dl3yc/SSTV-RX/README.md

SSTV-RX
=======

a reciever for SSTV on 2m ham radio band as software defined radio
