dl3yc/SSTV-RX/hw/images/adf4360_full.jpg

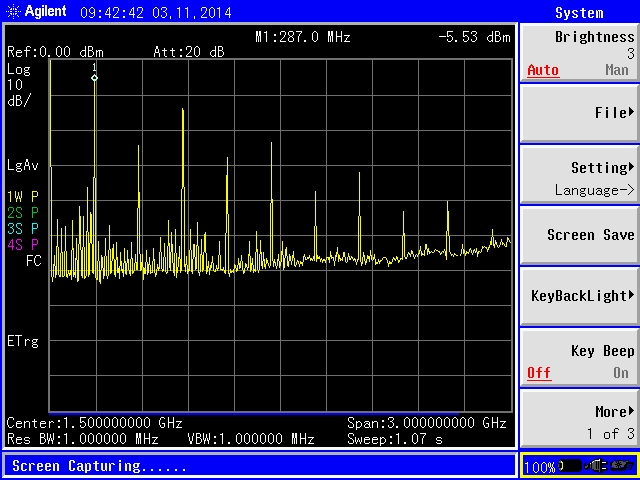
hw/images/adf4360_full.jpg
