dl3yc/SSTV-RX/hw/images/adf4360_narrow.jpg

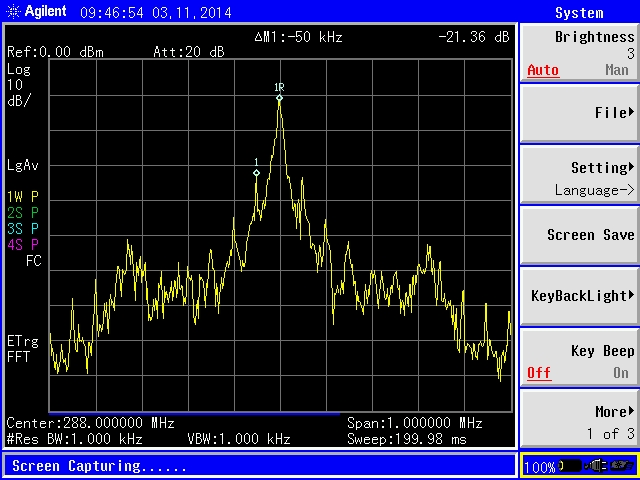
hw/images/adf4360_narrow.jpg
