dl3yc/SSTV-RX/hw/images/adf4360_spurs.jpg

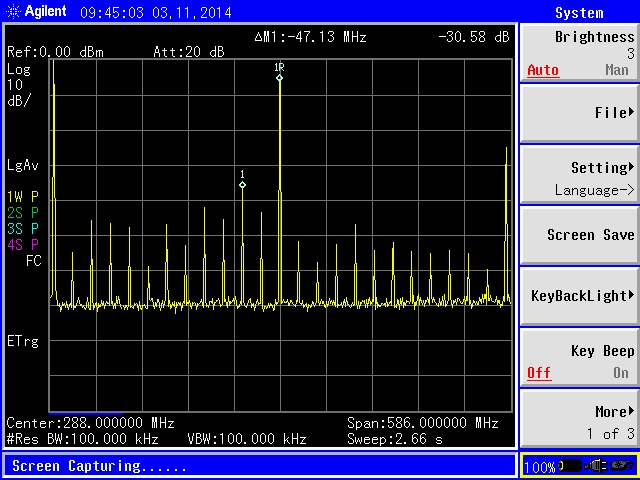
hw/images/adf4360_spurs.jpg
