dl3yc/SSTV-RX/hw/sim/pllsim.png

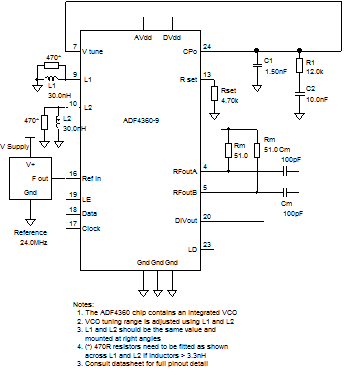
hw/sim/pllsim.png
