dl3yc/SSTV-RX/hw/sim/signal_chain.png

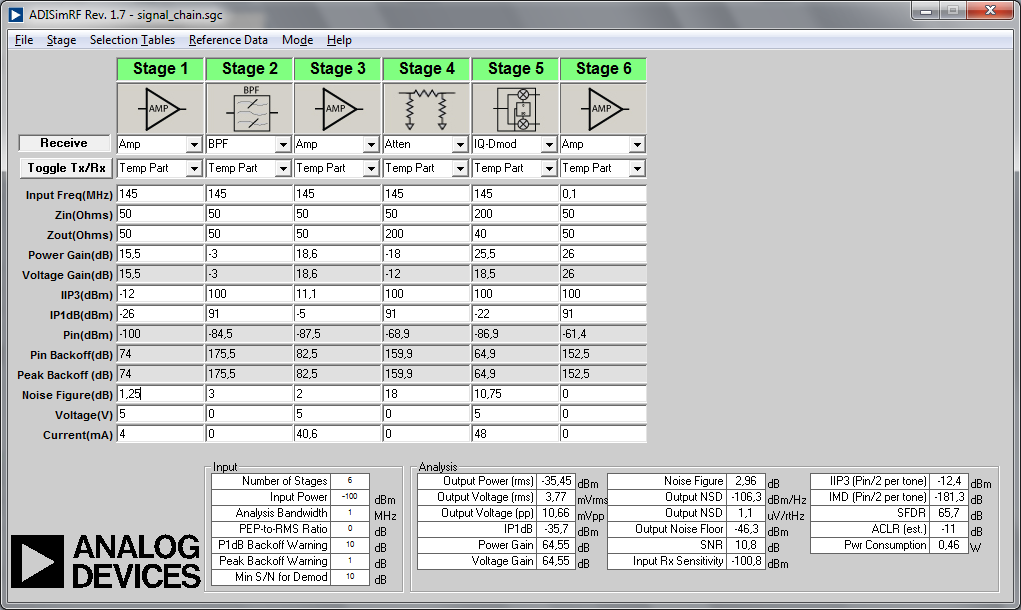
hw/sim/signal_chain.png
