dl3yc/SSTV-RX/hw/sim/BB-Filter.asc

C1: cap; 1n
C2: cap; 220p
L1: ind; 10µ
L2: ind; 4µ7
R1: res; 60
R2: res; 100
R3: res; 50k
V1: voltage; ""; AC 1; Rser=40
Named nets: 0, OUT, IN
.ac oct 100 10k 100Meg
