dl3yc/SSTV-RX/hw/lo.brd

## EAGLE design hw/lo.brd (2014-03-10)

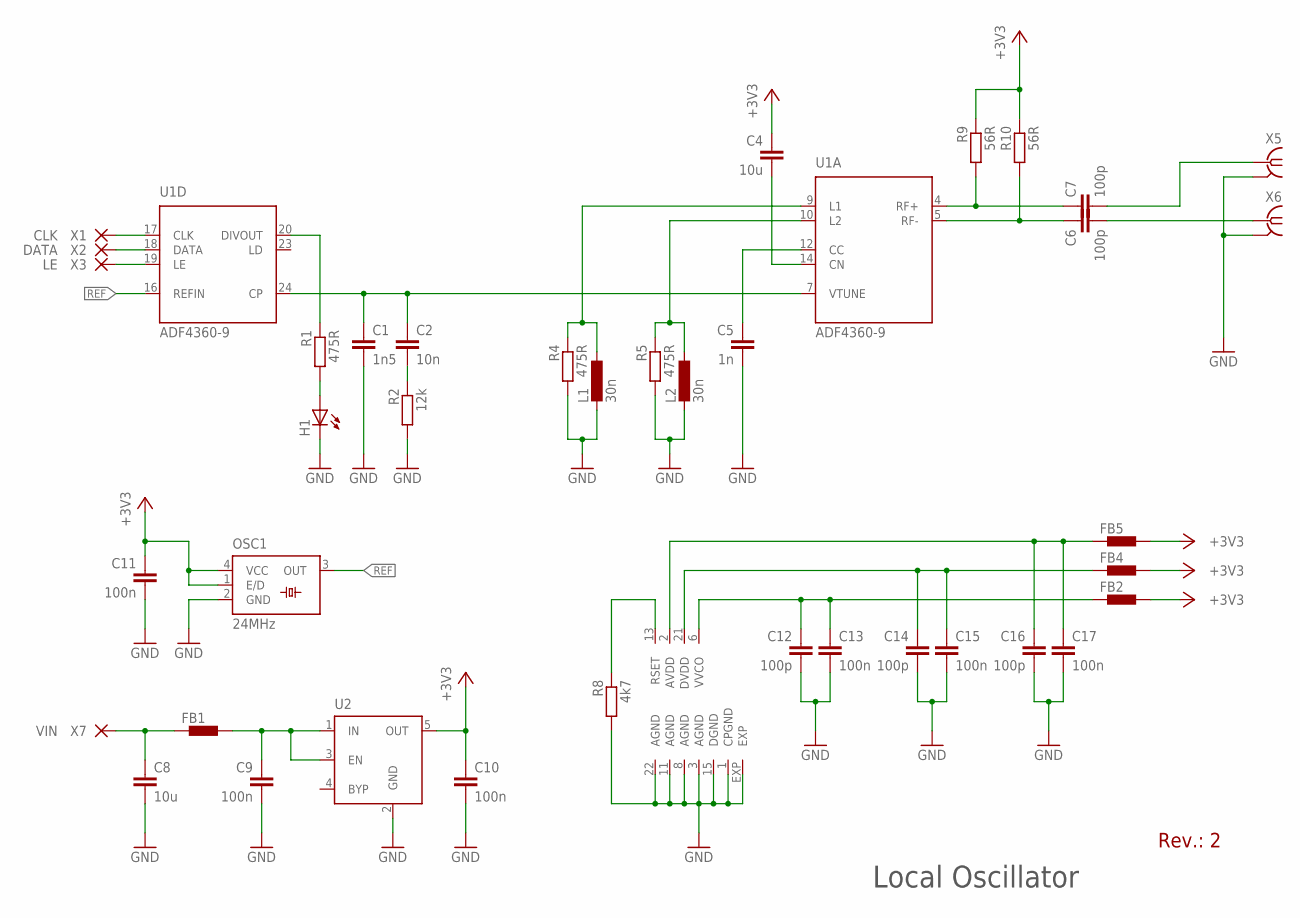
[picture p6: schematic lo.sch]

Parts:
C1: 1n5; C0402
C2: 10n; C0603
C4, C8: 10u; C0805
C5: 1n; C0603
C6, C7: 100p; C0402
C9, C10, C11, C13, C15, C17: 100n; C0603
C12, C14, C16: 100p; C0603
FB1, FB2, FB4, FB5: BML15H; R0603
H1: PL006-WCR13; SOT23
L1, L2: 30n; L2012C
OSC1: 24MHz; SM77H
R1: 475R; R1206
R2: 12k; R0603
R4, R5: 475R; R0603
R8: 4k7; R0603
R9, R10: 56R; R0603
U1: ADF4360-9; LFCSP24
U2: MIC5219XX; SOT23-5
X1: CLK; SMD1,27-2,54
X2: DATA; SMD1,27-2,54
X3: LE; SMD1,27-2,54
X5, X6: SMA-142-0701-881/886; J502-ND-142-0701-881/886
X7: VIN; SMD1,27-2,54

Connections:
+3V3: C4.1, C10.1, C11.1, FB2.2, FB4.2, FB5.2, OSC1.1 (E/D), OSC1.4 (VCC), R9.1, R10.1, U2.5 (OUT)
GND: C1.2, C5.2, C8.2, C9.2, C10.2, C11.2, C12.2, C13.2, C14.2, C15.2, C16.2, C17.2, H1.3 (C), L1.2, L2.2, OSC1.2 (GND), R2.2, R4.2, R5.2, R8.2, U1.1 (CPGND), U1.3 (AGND), U1.8 (AGND), U1.11 (AGND), U1.15 (DGND), U1.22 (AGND), U1.EXP, U2.2 (GND), X5.G@1 (GND), X5.G@2 (GND), X5.G@3 (GND), X5.G@4 (GND), X6.G@1 (GND), X6.G@2 (GND), X6.G@3 (GND), X6.G@4 (GND)
LD: C1.1, C2.1, U1.7 (VTUNE), U1.24 (CP)
unnamed: U1.17 (CLK), X1.1
unnamed: U1.18 (DATA), X2.1
unnamed: U1.19 (LE), X3.1
unnamed: C9.1, FB1.2, U2.1 (IN), U2.3 (EN)
unnamed: R1.1, U1.20 (DIVOUT)
unnamed: H1.1 (A), R1.2
unnamed: C2.2, R2.1
unnamed: C7.2, X5.1
unnamed: L2.1, R5.1, U1.10 (L2)
unnamed: C6.2, X6.1
unnamed: C5.1, U1.12 (CC)
unnamed: C8.1, FB1.1, X7.1
unnamed: C4.2, U1.14 (CN)
unnamed: C7.1, R9.2, U1.4 (RF+)
unnamed: C6.1, R10.2, U1.5 (RF-)
unnamed: R8.1, U1.13 (RSET)
unnamed: C12.1, C13.1, FB2.1, U1.6 (VVCO)
unnamed: C14.1, C15.1, FB4.1, U1.21 (DVDD)
unnamed: C16.1, C17.1, FB5.1, U1.2 (AVDD)
REF: OSC1.3 (OUT), U1.16 (REFIN)
RUT: L1.1, R4.1, U1.9 (L1)

Notes on the sheet:
Local Oscillator
Rev.: 2

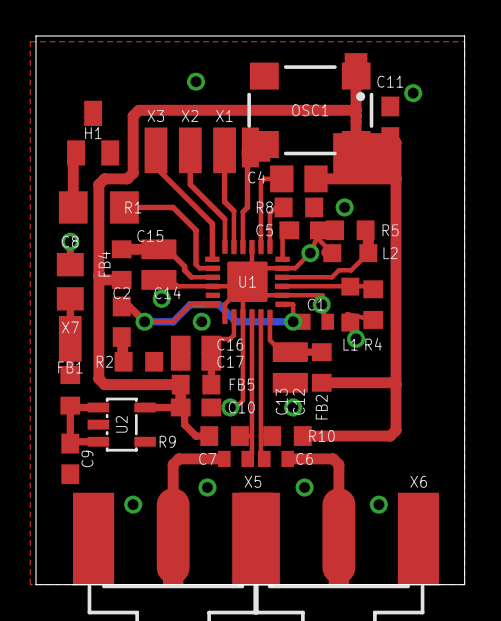
[picture p7: board lo.brd from above]

Board: 2 copper layers, 23.8 x 30.5 mm, 39 parts (0 on the bottom side), 24 nets.
