dl3yc/SSTV-RX/hw/diff2se.brd

## EAGLE design hw/diff2se.brd (2014-03-07)

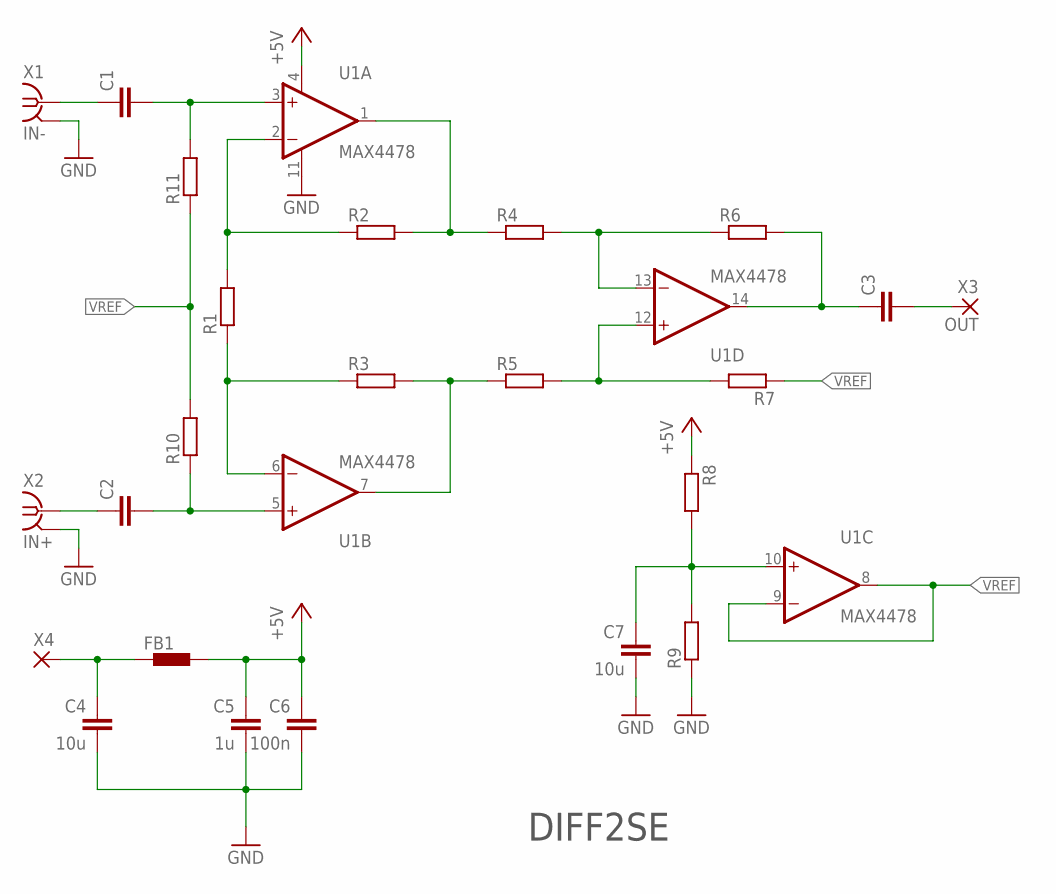
[picture p8: schematic diff2se.sch]

Parts:
C1, C2, C3: C-EUC0805K; C0805K
C4: 10u; C0805K
C5: 1u; C0805K
C6: 100n; C0805K
C7: 10u; C0402
FB1: BML15H; R0603
R1: R-EU_WSC01/2; WSC01/2
R2, R3, R4, R5, R6, R7: R-EU_R0805; R0805
R8, R9, R10, R11: R-EU_R0402; R0402
U1: MAX4478; SO14
X1: IN-; J502-ND-142-0701-881/886
X2: IN+; J502-ND-142-0701-881/886
X3: OUT; SMD1,27-2,54
X4: SMD2; SMD1,27-2,54

Connections:
+5V: C5.1, C6.1, FB1.2, R8.1, U1.4 (V+)
GND: C4.2, C5.2, C6.2, C7.2, R9.1, U1.11 (V-), X1.G@1 (GND), X1.G@2 (GND), X1.G@3 (GND), X1.G@4 (GND), X2.G@1 (GND), X2.G@2 (GND), X2.G@3 (GND), X2.G@4 (GND)
unnamed: R1.2, R2.1, U1.2 (-IN)
unnamed: R1.1, R3.1, U1.6 (-IN)
unnamed: R3.2, R5.1, U1.7 (OUT)
unnamed: R2.2, R4.1, U1.1 (OUT)
unnamed: C1.1, X1.1
unnamed: C1.2, R11.2, U1.3 (+IN)
unnamed: C2.1, X2.1
unnamed: C2.2, R10.1, U1.5 (+IN)
unnamed: R4.2, R6.1, U1.13 (-IN)
unnamed: R5.2, R7.2, U1.12 (+IN)
unnamed: C3.1, R6.2, U1.14 (OUT)
unnamed: C3.2, X3.1
unnamed: C4.1, FB1.1, X4.1
unnamed: C7.1, R8.2, R9.2, U1.10 (+IN)
VREF: R7.1, R10.2, R11.1, U1.8 (OUT), U1.9 (-IN)

Notes on the sheet:
DIFF2SE

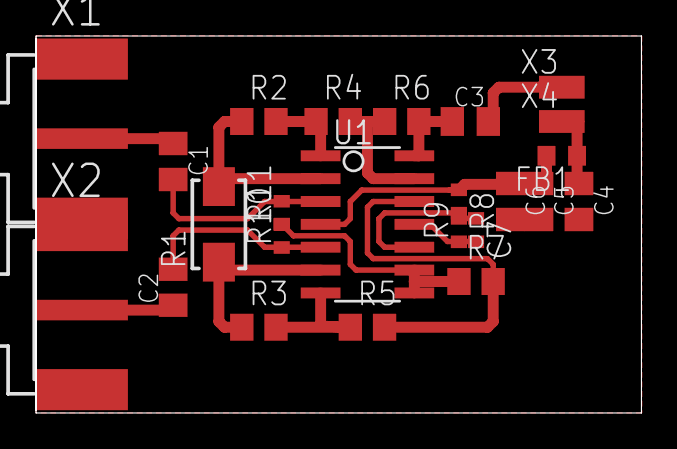
[picture p9: board diff2se.brd from above]

Board: 2 copper layers, 33.6 x 20.9 mm, 24 parts (0 on the bottom side), 17 nets.
