dl3yc/SSTV-RX/hw/iqdemod.brd

## EAGLE design hw/iqdemod.brd (2014-03-06)

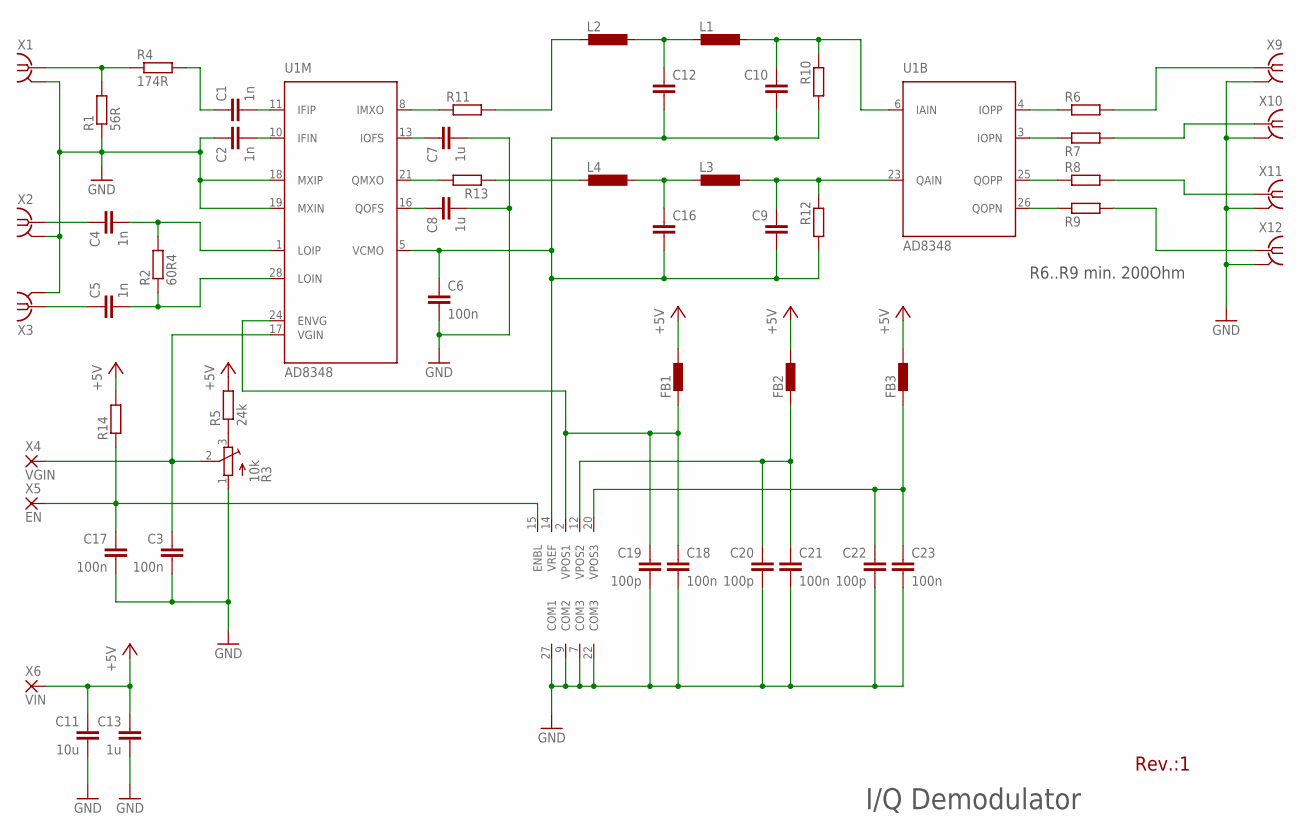
[picture p10: schematic iqdemod.sch]

Parts:
C1, C2, C4, C5: 1n; C0603
C3, C6, C17, C18, C21, C23: 100n; C0603
C7, C8, C13: 1u; C0603
C9, C10, C12, C16: C-EUC0603; C0603
C11: 10u; C0603
C19, C20, C22: 100p; C0603
FB1, FB2, FB3: BML15H; R0603
L1, L2, L3, L4: L-EUL2012C; L2012C
R1: 56R; R0603
R2: 60R4; R0603
R3: 10k; 3223J
R4: 174R; R0603
R5: 24k; R0603
R6, R7, R8, R9, R10, R11, R12, R13, R14: R-EU_R0603; R0603
U1: AD8348; TSSOP28
X1, X2, X3, X9, X10, X11, X12: SMA-142-0701-881/886; J502-ND-142-0701-881/886
X4: VGIN; SMD1,27-2,54
X5: EN; SMD1,27-2,54
X6: VIN; SMD1,27-2,54

Connections:
+5V: C11.1, C13.1, FB1.2, FB2.2, FB3.2, R5.2, R14.2, X6.1
GND: C2.1, C3.2, C6.2, C7.2, C8.2, C11.2, C13.2, C17.2, C18.2, C19.2, C20.2, C21.2, C22.2, C23.2, R1.1, R3.1 (A), U1.7 (COM3), U1.9 (COM2), U1.18 (MXIP), U1.19 (MXIN), U1.22 (COM3), U1.27 (COM1), X1.G@1 (2), X1.G@2 (2), X1.G@3 (2), X1.G@4 (2), X2.G@1 (2), X2.G@2 (2), X2.G@3 (2), X2.G@4 (2), X3.G@1 (2), X3.G@2 (2), X3.G@3 (2), X3.G@4 (2), X9.G@1 (2), X9.G@2 (2), X9.G@3 (2), X9.G@4 (2), X10.G@1 (2), X10.G@2 (2), X10.G@3 (2), X10.G@4 (2), X11.G@1 (2), X11.G@2 (2), X11.G@3 (2), X11.G@4 (2), X12.G@1 (2), X12.G@2 (2), X12.G@3 (2), X12.G@4 (2)
unnamed: C1.2, U1.11 (IFIP)
unnamed: C2.2, U1.10 (IFIN)
unnamed: R1.2, R4.1, X1.1
unnamed: C4.2, R2.2, U1.1 (LOIP)
unnamed: C5.2, R2.1, U1.28 (LOIN)
unnamed: C4.1, X2.1
unnamed: C3.1, R3.2 (S), U1.17 (VGIN), X4.1
unnamed: C5.1, X3.1
unnamed: C1.1, R4.2
unnamed: R3.3 (E), R5.1
unnamed: L2.2, R11.2
unnamed: L4.2, R13.1
unnamed: R6.1, U1.4 (IOPP)
unnamed: C8.1, U1.16 (QOFS)
unnamed: C7.1, U1.13 (IOFS)
unnamed: C12.1, L1.2, L2.1
unnamed: C10.1, L1.1, R10.1, U1.6 (IAIN)
unnamed: R7.1, U1.3 (IOPN)
unnamed: R8.1, U1.25 (QOPP)
unnamed: R9.1, U1.26 (QOPN)
unnamed: R6.2, X9.1
unnamed: R7.2, X10.1
unnamed: R8.2, X11.1
unnamed: R9.2, X12.1
unnamed: R11.1, U1.8 (IMXO)
unnamed: C17.1, R14.1, U1.15 (ENBL), X5.1
unnamed: C16.1, L3.2, L4.1
unnamed: C9.1, L3.1, R12.1, U1.23 (QAIN)
unnamed: R13.2, U1.21 (QMXO)
unnamed: C18.1, C19.1, FB1.1, U1.2 (VPOS1), U1.24 (ENVG)
unnamed: C20.1, C21.1, FB2.1, U1.12 (VPOS2)
unnamed: C22.1, C23.1, FB3.1, U1.20 (VPOS3)
VREF: C6.1, C9.2, C10.2, C12.2, C16.2, R10.2, R12.2, U1.5 (VCMO), U1.14 (VREF)

Notes on the sheet:
I/Q Demodulator
Rev.:1
R6..R9 min. 200Ohm

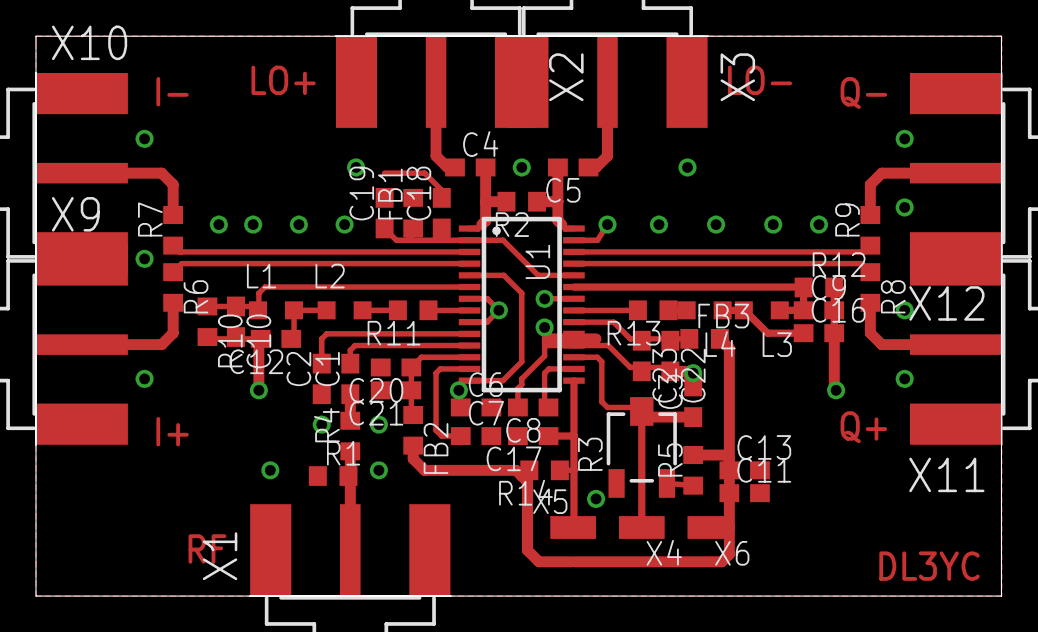
[picture p11: board iqdemod.brd from above]

Board: 2 copper layers, 53.6 x 31.1 mm, 53 parts (0 on the bottom side), 35 nets.
