dl3yc/SSTV-RX/(commit log)

2014-03-05 switch ENVG and VGIN to minimize crossing in schematic
2014-03-05 first draft of i/q demodulator
    [iqdemod.sch]
2014-03-05 add simulation of i/q demodulator baseband filter
2014-03-05 implement new baseband filter topology and add pad for supply
    [iqdemod.sch]
2014-03-05 simulate new filter topology(4th order lc filter)
2014-03-05 calculate values for baseband filter
2014-03-06 rev. 1: finished board
    [iqdemod.brd, iqdemod.sch]
2014-03-06 add differential to single ended converter
    [diff2se.brd, diff2se.sch]
2014-03-07 correct signal common to vref
    [diff2se.brd, diff2se.sch]
2014-03-07 first draft of local oscillator
    [lo.sch]
2014-03-07 simulate pll loop filter
    frequency range 288MHz - 292MHz
    channel spacing is 50kHz
    In-band Phase Noise is -93,7dBc/Hz
2014-03-07 simulate pll filter
2014-03-07 use loop filter values from simulation
    [lo.sch]
2014-03-08 make adf4360 footprint more comfortable to solder
2014-03-08 rev.1: finished lo board
    [lo.brd, lo.sch]
2014-03-08 add rf signal chain simulation with ADISimRF
2014-03-10 optimize layout for easier soldering
    [lo.brd, lo.sch]
2014-03-10 add wiring info
